kartoffelfighter/seniorsRemote/README.md

# seniorsRemote
A very basic remote tv (IR) control for seniors (and lazy people like me)

# first etched pcb
the first etched pcb just moved to the master branch
