kartoffelfighter/seniorsRemote/(list of files, cad)

Other CAD files:
case/Gehäuse_1.iam
case/Oberschale.ipt
case/fantimote.ipt
case/fantimote.kicad_pcb.iam
case/fantimote.kicad_pcb_Kontur.ipt
