kartoffelfighter/seniorsRemote/pcb/fantimote.kicad_pcb

## KiCad design pcb/fantimote.kicad_pcb (2018-08-05)

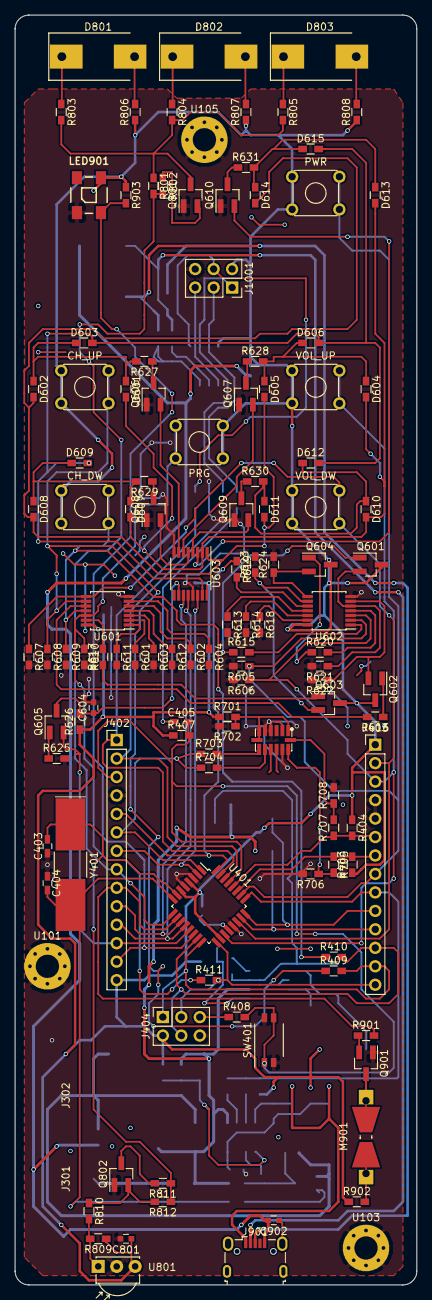
[picture p1: board fantimote.kicad_pcb from above]

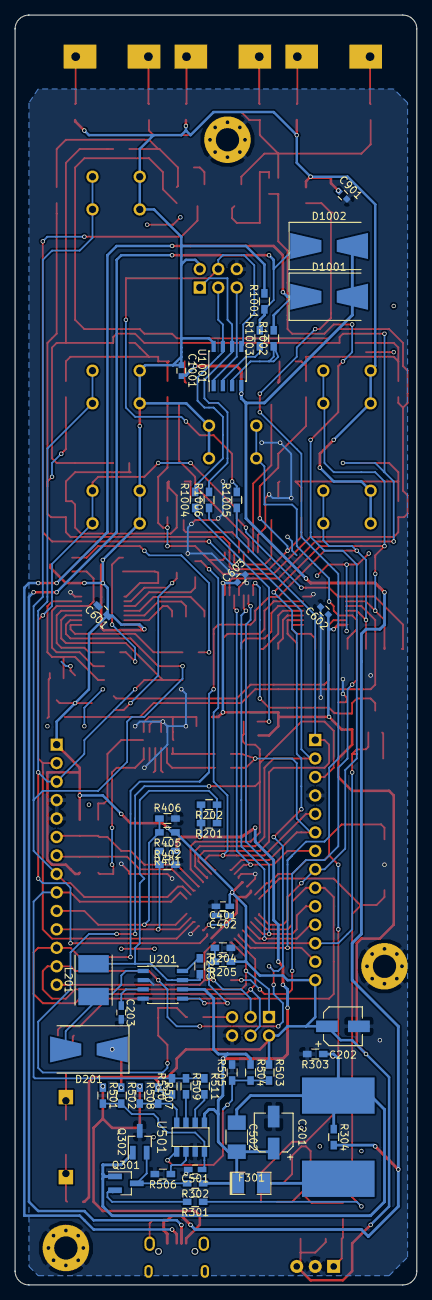
[picture p2: board fantimote.kicad_pcb from below]

Board: 2 copper layers, 55.2 x 174.6 mm, 176 parts (52 on the bottom side), 121 nets.

Parts:
C201: 10µ; CP_Elec_5x5.8
C202: 100µ; CP_Elec_5x5.8
C203: 1n; C_0603_HandSoldering
C401, C402, C501, C601: 100n; C_0603_HandSoldering
C403, C404: 10p; C_0603_HandSoldering
C405: 0,1µF; C_0603_HandSoldering
C502: 10µ; C_1210_HandSoldering
C602, C603, C801, C901, C1001: 100n; C_0603
C604: 1nF; C_0603
C902: 1µ; C_0603
CH_DW: SW_Push_Dual; SW_TH_Tactile_Omron_B3F-10xx
CH_UP: SW_Push_Dual; SW_TH_Tactile_Omron_B3F-10xx
D201: 1N5819; D_SMB-SMC_Universal_Handsoldering
D601, D602, D603, D604, D605, D606, D607, D608, D609, D610, D611, D612, D613, D614, D615: LED; R_0603_HandSoldering
D801, D802, D803: IR204A; D_SMC-RM10_Universal_Handsoldering
D1001, D1002: 3V6; D_SMB-SMC_Universal_Handsoldering
F301: Fuse; SMD-1210_Pol
IC701: ADXL345; ADXL3x5
J301: BAT+; SolderWirePad_single_SMD_5x10mm
J302: BAT-; SolderWirePad_single_SMD_5x10mm
J402: DIGITAL_DEBUG; Socket_Strip_Straight_1x14_Pitch2.54mm
J403: ANALOG_DEBUG; Socket_Strip_Straight_1x14_Pitch2.54mm
J404: ISP_atmega; Socket_Strip_Straight_2x03_Pitch2.54mm
J901: USB_OTG; USB_Micro-B_Wuerth-629105150521
J1001: ISP_tiny; Socket_Strip_Straight_2x03_Pitch2.54mm
L201: 68µH; L_Taiyo-Yuden_NR-50xx_HandSoldering
LED901: WS2812B
M901: Vibration_motor; Resistor_SMD+THTuniversal_0805to2512_RM10_HandSoldering
PRG: SW_Push_Dual; SW_TH_Tactile_Omron_B3F-10xx
PWR: SW_Push_Dual; SW_TH_Tactile_Omron_B3F-10xx
Q301, Q302, Q605, Q606, Q607, Q608, Q609, Q610, Q801, Q802, Q901: S8050; SOT-23_Handsoldering
Q601, Q602, Q603, Q604: BC807; SOT-23_Handsoldering
R201, R202: 0R5; R_0603_HandSoldering
R203: 180R; R_0603_HandSoldering
R204: 3k9; R_0603_HandSoldering
R205, R301, R302: 12k; R_0603_HandSoldering
R303, R304, R408, R409, R410, R411, R501, R505, R508, R619, R802, R806, R807, R808, R812, R901, R902, R1004, R1005, R1006: 0R0; R_0603_HandSoldering
R401, R402, R405, R406, R509, R510, R615, R616, R617, R620, R621, R622, R623, R624, R626, R705, R707, R903: 100k; R_0603_HandSoldering
R403, R404: 22k; R_0603_HandSoldering
R407, R601, R602, R603, R604, R605, R606, R607, R608, R609, R610, R611, R612, R613, R614, R618: 10k; R_0603_HandSoldering
R502, R503, R504, R625, R801, R811: N/A; R_0603_HandSoldering
R506: 2k0; R_0603_HandSoldering
R507: n/a; R_0603_HandSoldering
R511: 200k; R_0603_HandSoldering
R627, R628, R629, R630, R631: 470R; R_0603_HandSoldering
R701: 90k; R_0603_HandSoldering
R702, R706, R708: 45k; R_0603_HandSoldering
R703: INT1; R_0603_HandSoldering
R704: INT2; R_0603_HandSoldering
R803, R804, R805: 560R; R_0603_HandSoldering
R809: 24k; R_0603_HandSoldering
R810: 100R; R_0603_HandSoldering
R1001: 1k5; R_0603_HandSoldering
R1002, R1003: 68R; R_0603_HandSoldering
SW401: RESET; SW_DIP_x2_W6.15mm_Slide_Omron_A6H
U101, U103, U105: mounting_hole; MountingHole_3.2mm_M3_Pad_Via
U201: MC34063; SOIC-8_3.9x4.9mm_Pitch1.27mm
U401: ATMEGA328-AU; TQFP-32_7x7mm_Pitch0.8mm
U501: TPS4056; SOP-8
U601, U602: 74HC02; TSSOP-14_4.4x5mm_Pitch0.65mm
U603: 74HC595; TSSOP-16_4.4x5mm_Pitch0.65mm
U801: TSDP341xx; IRReceiver_Vishay_MOLD-3pin
U1001: ATTINY85; SOIC-8_3.9x4.9mm_Pitch1.27mm
VOL_DW: SW_Push_Dual; SW_TH_Tactile_Omron_B3F-10xx
VOL_UP: SW_Push_Dual; SW_TH_Tactile_Omron_B3F-10xx
Y401: Crystal; Crystal_SMD_SeikoEpson_MC405-2pin_9.6x4.1mm_HandSoldering

Connections:
+5V: C202.1, C401.1, C601.1, C602.1, C603.1, C801.1, C901.1, C1001.1, CH_DW.1, CH_DW.3, CH_UP.1, CH_UP.3, D201.1, J402.14, J403.1, J404.2, J1001.2, LED901.1, PRG.1, PRG.3, PWR.1, PWR.3, Q601.3, Q602.3, Q603.3, Q604.3, R205.1, R403.1, R404.1, R405.1, R407.1, R502.1, R503.1, R507.1, R510.1, R626.1, R701.1, R806.1, R807.1, R808.1, R809.1, R902.1, R903.1, R1001.2, U401.4, U401.6, U401.18, U601.14, U602.14, U603.16, U801.3, U1001.8, VOL_DW.1, VOL_DW.3, VOL_UP.1, VOL_UP.3
+5VD: J901.1, R501.1, R508.1
+BATT: C201.1, C502.2, F301.1, R201.2, R202.2, R302.1, R401.1, R504.1, U201.6, U501.5
-BATT: C502.1, J302.1, Q301.1, Q302.1, R303.1, R304.1
A0: J403.11, R401.2, R402.1, U401.23
A1: J403.10, R405.2, R406.1, U401.24
A2: J403.9, R509.1, R510.2, R511.1, U401.25
A3: J403.8, PWR.2, PWR.4, R605.1, U401.26, U602.2
A4: J403.7, R403.2, R705.1, U401.27
A5: J403.6, R404.2, R707.1, U401.28
A6: J403.3, R606.1, U401.19, U602.3, VOL_UP.2, VOL_UP.4
A7: J403.2, R607.1, U401.22, U601.8, VOL_DW.2, VOL_DW.4
CH_DW: CH_DW.2, CH_DW.4, R410.1, R609.1, U601.11
CH_UP: CH_UP.2, CH_UP.4, R409.1, R608.1, U601.9
D2: J402.5, R619.1, U401.32
D3: J402.6, R703.1, R704.1, U401.1
D4: J402.7, U401.2, U603.14
D5: J402.8, R801.2, R802.2, U401.9
D6: J402.9, R901.2, U401.10
D7: J402.10, U401.11, U603.11
D8: J402.11, U401.12, U603.12
D9: J402.12, Q605.2, U401.13
D10: J402.13, LED901.4, R903.2, U401.14
DTR: C405.1, R1004.1
GND: C201.2, C202.2, C203.2, C401.2, C402.2, C403.1, C404.1, C501.2, C601.2, C602.2, C603.2, C604.2, C801.2, C901.2, IC701.2, IC701.4, IC701.5, IC701.12, J402.4, J403.4, J403.5, J404.6, J1001.6, LED901.3, Q302.3, Q606.1, Q607.1, Q608.1, Q609.1, Q610.1, Q801.1, Q802.1, Q901.1, R204.1, R303.2, R402.2, R406.2, R505.2, R506.2, R601.2, R602.2, R603.2, R604.2, R605.2, R606.2, R607.2, R608.2, R609.2, R610.2, R611.2, R612.2, R613.2, R614.2, R618.2, R621.2, R622.2, R623.2, R624.2, R625.2, R702.2, R706.2, R708.2, SW401.2, SW401.4, U101.1, U103.1, U105.1, U201.2, U201.4, U401.3, U401.5, U401.21, U501.3, U601.7, U602.7, U603.8, U603.13, U801.2
GNDD: C902.2, C1001.2, D1001.2, D1002.2, J901.5, R304.2, U1001.4
IR_RECEIVE: C403.2, R811.1, R812.1, U401.7, Y401.1
MISO: J403.13, J404.1, R409.2, U401.16
MOSI: J403.12, J404.4, R410.2, U401.15
unnamed: C203.1, U201.3
unnamed: C402.1, U401.20
unnamed: C501.1, R501.2, R502.2, U501.4
unnamed: C604.1, Q605.3, R626.2, U603.10
unnamed: C902.1, J901.6
unnamed: D201.2, L201.1, U201.1
unnamed: D601.1, D602.1, D603.1, R627.2
unnamed: D601.2, D604.2, D607.2, D610.2, D613.2, U603.2
unnamed: D602.2, D605.2, D608.2, D611.2, D614.2, U603.1
unnamed: D603.2, D606.2, D609.2, D612.2, D615.2, U603.15
unnamed: D604.1, D605.1, D606.1, R628.2
unnamed: D607.1, D608.1, D609.1, R629.2
unnamed: D610.1, D611.1, D612.1, R630.2
unnamed: D613.1, D614.1, D615.1, R631.2
unnamed: D801.1, R803.1
unnamed: D801.2, R806.2
unnamed: D802.1, R804.1
unnamed: D802.2, R807.2
unnamed: D803.1, R805.1
unnamed: D803.2, R808.2
unnamed: F301.2, J301.1
unnamed: IC701.1, IC701.6, IC701.7, R701.2, R702.1
unnamed: IC701.8, R703.2
unnamed: IC701.9, R704.2
unnamed: IC701.13, R705.2, R706.1
unnamed: IC701.14, R707.2, R708.1
unnamed: J404.5, R408.1
unnamed: L201.2, R201.1, R202.1, R203.2, U201.7
unnamed: M901.1, R902.2
unnamed: M901.2, Q901.3
unnamed: Q301.2, R301.2
unnamed: Q301.3, Q302.2, R302.2
unnamed: Q601.1, R615.1
unnamed: Q601.2, R621.1, U602.5
unnamed: Q602.1, R616.1
unnamed: Q602.2, R622.1, U602.6
unnamed: Q603.1, R617.1
unnamed: Q603.2, R623.1, U602.9
unnamed: Q604.1, R620.1
unnamed: Q604.2, R624.1, U602.8
unnamed: Q605.1, R625.1
unnamed: Q606.2, U603.7
unnamed: Q606.3, R627.1
unnamed: Q607.2, U603.6
unnamed: Q607.3, R628.1
unnamed: Q608.2, U603.5
unnamed: Q608.3, R629.1
unnamed: Q609.2, U603.4
unnamed: Q609.3, R630.1
unnamed: Q610.2, U603.3
unnamed: Q610.3, R631.1
unnamed: Q801.2, R802.1
unnamed: Q801.3, R801.1, R803.2, R804.2, R805.2
unnamed: Q802.2, R810.1, R812.2
unnamed: Q802.3, R811.2
unnamed: Q901.2, R901.1
unnamed: R203.1, U201.8
unnamed: R204.2, R205.2, U201.5
unnamed: R503.2, R504.2, R505.1, U501.1
unnamed: R506.1, U501.2
unnamed: R507.2, R508.2, U501.8
unnamed: R509.2, U501.7
unnamed: R511.2, U501.6
unnamed: R601.1, U601.2
unnamed: R602.1, U601.5
unnamed: R603.1, U601.3
unnamed: R604.1, U601.6
unnamed: R611.1, U601.1
unnamed: R612.1, U601.4
unnamed: R613.1, U602.11
unnamed: R614.1, U602.12
unnamed: R615.2, U602.1
unnamed: R616.2, U601.10
unnamed: R617.2, U601.13
unnamed: R618.1, U602.13
unnamed: R619.2, U602.10
unnamed: R620.2, U602.4
unnamed: R809.2, R810.2, U801.1
unnamed: R1002.1, U1001.3
unnamed: R1003.1, U1001.2
PB7: C404.2, R301.1, U401.8, Y401.2
PRG: PRG.2, PRG.4, R411.1, R610.1, U601.12
RESET: C405.2, J402.3, R407.2, R408.2, SW401.1, SW401.3, U401.29
RXI: J402.2, R1006.1, U401.30
SCK: J403.14, J404.3, R411.2, U401.17
TXD: J402.1, R1005.1, U401.31
USB_D+: D1001.1, J901.3, R1002.2
USB_D-: D1002.1, J901.2, R1001.1, R1003.2
tiny_MISO: J1001.1, R1006.2, U1001.6
tiny_MOSI: J1001.4, R1005.2, U1001.5
tiny_RESET: J1001.5, U1001.1
tiny_SCK: J1001.3, R1004.2, U1001.7
