kartoffelfighter/seniorsRemote/(threads)

Thread 1 (2018-06-23):

prototype pcb

kartoffelfighter, 2018-06-23:
# A prototype PCB is needed to develop the firmware

The prototype pcb should have all experimental features attached to an arduino-like pcb ("shield") for arduino uno

kartoffelfighter, 2018-07-29:
removed all the testpoints for less complicated routing
thrown idea for "break-away" testpoint pcb

kartoffelfighter, 2018-07-31:
ordered a prototype pcb

kartoffelfighter, 2018-08-05:
pcb arrived, debugging..

soldered step-up: works!

Thread 3 (2018-06-23):

hardware to wake up from sleep

kartoffelfighter, 2018-06-23:
# Waking up

To wake the controller from sleep a ISR will be used.
To interrupt the processor, a single "wake-up" pin must be used, as the arduino uno only supports to pins.

The plugged in charge connector should wake the processor, also any clicked button must wake the processor.

Idea:
All buttons will be connected to a schmitt-trigger OR gate, the output is connected to interrupt pin 1
The 5V-Signal from the USB-Port will be connected to a (N)AND to enable a disable from the processor

kartoffelfighter, 2018-07-07:
schmitt trigger OR gate not found, used NOR gates instead. Pull-Up resistors should do the trick.
all gates connected together to a single LOW-active output, the falling signal should wake the controller using the ISR

Accelerometer connected to second ISR to interrupt when activity (the remote is moved)

to do:
- Wake if plugged in

kartoffelfighter, 2018-07-13:
cancelled wake if plugged in, if remote ist moved the wake-if-moved will trigger and wake the controller right before plugging in

kartoffelfighter, 2018-07-27:
propably the whole interrupt-trigger circuit of the keys is not necessary because the adxl can wake the controller.
beta-pcb will have it anyways so redundancy is given.

Thread 4 (2018-06-23):

accu interaction

kartoffelfighter, 2018-06-23:
# accu interaction from processor to remote

to processor should be able to read the voltage from the accu using an internal ADC.
Also the chargecontroller's outputs for charging and full need to be connected to digital pins to the processor, here maybe a schmitt-trigger is needed.

kartoffelfighter, 2018-07-07:
internal adc for reading the accuvoltage,
accu connected to stepUp converter,
TPS4056 battery charger schematic added
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

Thread 5 (2018-06-23):

stepUp converter

kartoffelfighter, 2018-06-23:
# 5V for the atmega

The atmega microcontroller needs 5V to operate.
The power source of the remote is a lipo-accu which outputs a charge dependend voltage between 3,7V an 4,2V.

The stepUp circuit needs to be designed

The power-consumption of the stepup converter needs to be measured to get to know if its necessary to disable the stepup converter in adition to save some power.

kartoffelfighter, 2018-07-06:
Done
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

Debugging needs to be done, need some more information about power consumption of just the stepUp converter

Maybe some kind of mosfet needs to be placed between the battery and the step up converter to disable it (possibility to reset the processor with a software switch)

kartoffelfighter, 2018-07-07:
killSwitch added

kartoffelfighter, 2018-08-05:
soldered the parts to prototype pcb: working step-up!

Closed 2018-08-05.

Thread 6 (2018-07-07):

Accelerometer integration

kartoffelfighter, 2018-07-07:
ADXL345 in SPI mode
Interrupts for activity

kartoffelfighter, 2018-07-07:
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
integration as far as possible done, waiting for hardware to debug and test

kartoffelfighter, 2018-07-13:
wired on prototype pcb, waiting for dev.shield to receive

kartoffelfighter, 2018-07-29:
see https://github.com/kartoffelfighter/seniorsRemote/tree/nightly/firmware/adxl_testing/adxl_testing for possible firmware integration

Note:
Resistors in datalines are not necesseray, as the speed of signals is high enough, the max. signal voltage will not reach the abs.max.value of adxl.

Thread 7 (2018-07-13):

IR Direct Receiver integration

kartoffelfighter, 2018-07-13:
IR direct communication for easy programming

to do:
- programming adapter development
- FW integration of IR direct (only one way)

kartoffelfighter, 2018-07-27:
very low priority, communication is possible using usb, SPI, I2C, UART.....
no need for IR direct so far
