kartoffelfighter/seniorsRemote/firmware/adxl_testing/adxl_testing/src/main.cpp

#include <Arduino.h>

// I2C device class (I2Cdev) demonstration Arduino sketch for ADXL345 class
// 10/7/2011 by Jeff Rowberg <jeff@rowberg.net>
// Updates should (hopefully) always be available at https://github.com/jrowberg/i2cdevlib
//
// Changelog:
//     2011-10-07 - initial release

/* ============================================
I2Cdev device library code is placed under the MIT license
Copyright (c) 2011 Jeff Rowberg

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
THE SOFTWARE IS PROVIDED "AS IS", WITHOUT WARRANTY OF ANY KIND, EXPRESS OR
IMPLIED, INCLUDING BUT NOT LIMITED TO THE WARRANTIES OF MERCHANTABILITY,
FITNESS FOR A PARTICULAR PURPOSE AND NONINFRINGEMENT. IN NO EVENT SHALL THE
AUTHORS OR COPYRIGHT HOLDERS BE LIABLE FOR ANY CLAIM, DAMAGES OR OTHER
LIABILITY, WHETHER IN AN ACTION OF CONTRACT, TORT OR OTHERWISE, ARISING FROM,
OUT OF OR IN CONNECTION WITH THE SOFTWARE OR THE USE OR OTHER DEALINGS IN
THE SOFTWARE.
===============================================
*/

// Arduino Wire library is required if I2Cdev I2CDEV_ARDUINO_WIRE implementation
// is used in I2Cdev.h
#include "Wire.h"

// I2Cdev and ADXL345 must be installed as libraries, or else the .cpp/.h files
// for both classes must be in the include path of your project
#include "I2Cdev.h"
#include "ADXL345.h"

// class default I2C address is 0x53
// specific I2C addresses may be passed as a parameter here
// ALT low = 0x53 (default for SparkFun 6DOF board)
// ALT high = 0x1D
ADXL345 accel;

int16_t ax, ay, az;

int position = 0;       // 1 = top 10 = head, 2 = left, 3 = right, 4 = belly, 5 = back
int oldPos = 0;

int TRESH_ACT = 10; // treshold of magnitude to trigger ISR

int timeout = 0;
int i2ctimeout = 1000; //mSecs until i2c timout should trigger and end 

#define LED_PIN 13 // (Arduino is 13, Teensy is 6)
bool blinkState = false;

void wakeISR();     // head of wakeISR()

void setup() {
    // join I2C bus (I2Cdev library doesn't do this automatically)
    Wire.begin();

    // initialize serial communication
    // (38400 chosen because it works as well at 8MHz as it does at 16MHz, but
    // it's really up to you depending on your project)
    Serial.begin(9600);

    // initialize device
    Serial.println("MYSELF | initialize i2c connection");
    accel.initialize();

    // verify connection
    Serial.println("ADXL | Testing device connections...");
    if(accel.testConnection()){
        Serial.println("ADXL | ADXL345 connected");
    }
    else {
        Serial.println("ADXL | ADXL345 no connection. shutting down");
        while(1){
            asm("nop;");
        }

    }
    
    Serial.print("ADXL | AutoSleepEnabled: ");
    Serial.println(accel.getAutoSleepEnabled());
    Serial.print("ADXL | Setting interrupt to interrupt when activity: ");
    accel.setIntActivityEnabled(true);
    Serial.println(accel.getIntActivityEnabled());
    Serial.print("ADXL | TRESH_ACT:");
    Serial.println(accel.getActivityThreshold());
    Serial.print("ADXL | Setting up the TRESH_ACT register to ");
    Serial.println(TRESH_ACT);
    accel.setActivityThreshold(TRESH_ACT);
    Serial.print("ADXL | NEW treshold: ");
    Serial.println(accel.getActivityThreshold());

    Serial.print("MYSELF | setting Up my ISR");
    attachInterrupt(1, wakeISR, RISING);
    

}

void loop() {
    // read raw accel measurements from device
    //accel.getAcceleration(&ax, &ay, &az);

    asm("nop");
    // display tab-separated accel x/y/z values
    //Serial.print("accel:\t");
    //Serial.print(ax); Serial.print("\t");
    //Serial.print(ay); Serial.print("\t");
    //Serial.println(az);

}

void wakeISR() {
    Serial.println("i was woken by ADXL");
}
