kartoffelfighter/seniorsRemote/(commit log)

2018-07-07 ADXL integration
    [ADXL.sch]
2018-07-07 WIP: prototype PCB
    [buttons.sch, charger.sch, fantimote.kicad_pcb, fantimote.sch, killSwitch.sch, stepUp.sch]
2018-07-13 nightly | pcb build, routing, placing
    [IR.sch, actuators.sch, buttons.sch, charger.sch, fantimote.sch, killSwitch.sch, stepUp.sch, tiny_usb.sch]
2018-07-27 first firmware testing with adxl dev board
2018-07-27 new routes, changed few parts for shorter tracks
    [fantimote.kicad_pcb]
2018-07-29 new components list with changed footprints
2018-07-29 WIP: large amount of new routes, removed testpoints
    [fantimote.kicad_pcb]
2018-07-31 imported 3d files from pcb
    [Gehäuse_1.iam, Oberschale.ipt, fantimote.ipt]
2018-07-31 gerber files for factoring at allpcb
    [fantimote-B.Cu.gbr, fantimote-B.Fab.gbr, fantimote-B.Mask.gbr, fantimote-B.Paste.gbr, fantimote-Edge.Cuts.gbr, fantimote-F.Cu.gbr, fantimote-F.Fab.gbr, fantimote-F.Mask.gbr]
2018-07-31 added 3d files, added routes, added copper layers, added silkscreen
    [fantimote.kicad_pcb]
2018-07-31 3d files for case
    [fantimote.kicad_pcb.iam, fantimote.kicad_pcb_Kontur.ipt]
