kartoffelfighter/seniorsRemote/(notices)

Notices in the files:
pcb/fantimote.sch:
GPL-3.0 License
